Bdabrowsky/T800-SRM/README.md

# T800-SRM
T800 is a solid rocket motor developed for Odkrywcy Diamentow grant program in years 2021-2024. This repository is a technical report of this project
