Bdabrowsky/T800-SRM/Design files/T800.step

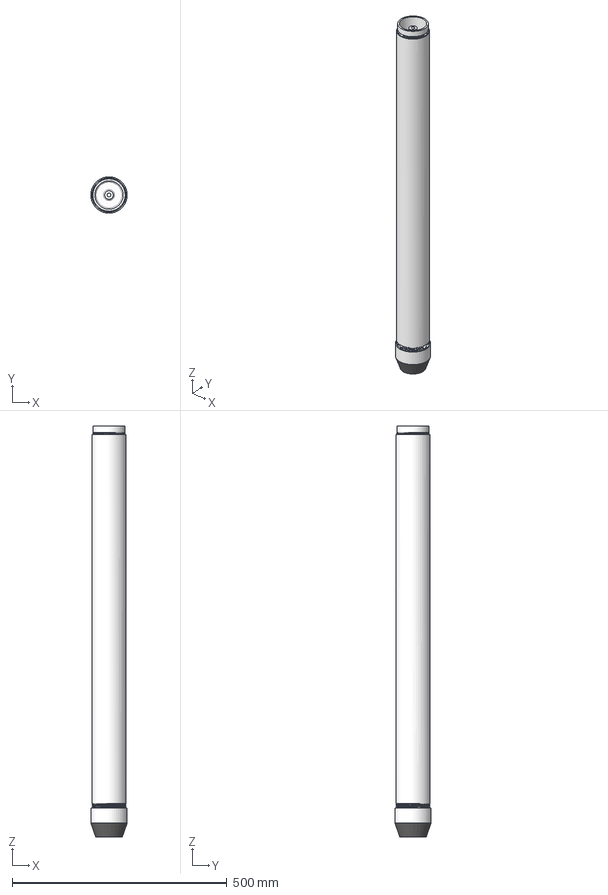
[picture p8: CAD file, 2024-02-15]
Design files/T800.step
84.9 x 85.0 x 957.7 mm
Casing
Graphite
Liner
Casting tube x 6
Fuel grain x 6
Top closure
Liner cap
