Bdabrowsky/T800-SRM/Images/Assembly cross section.png

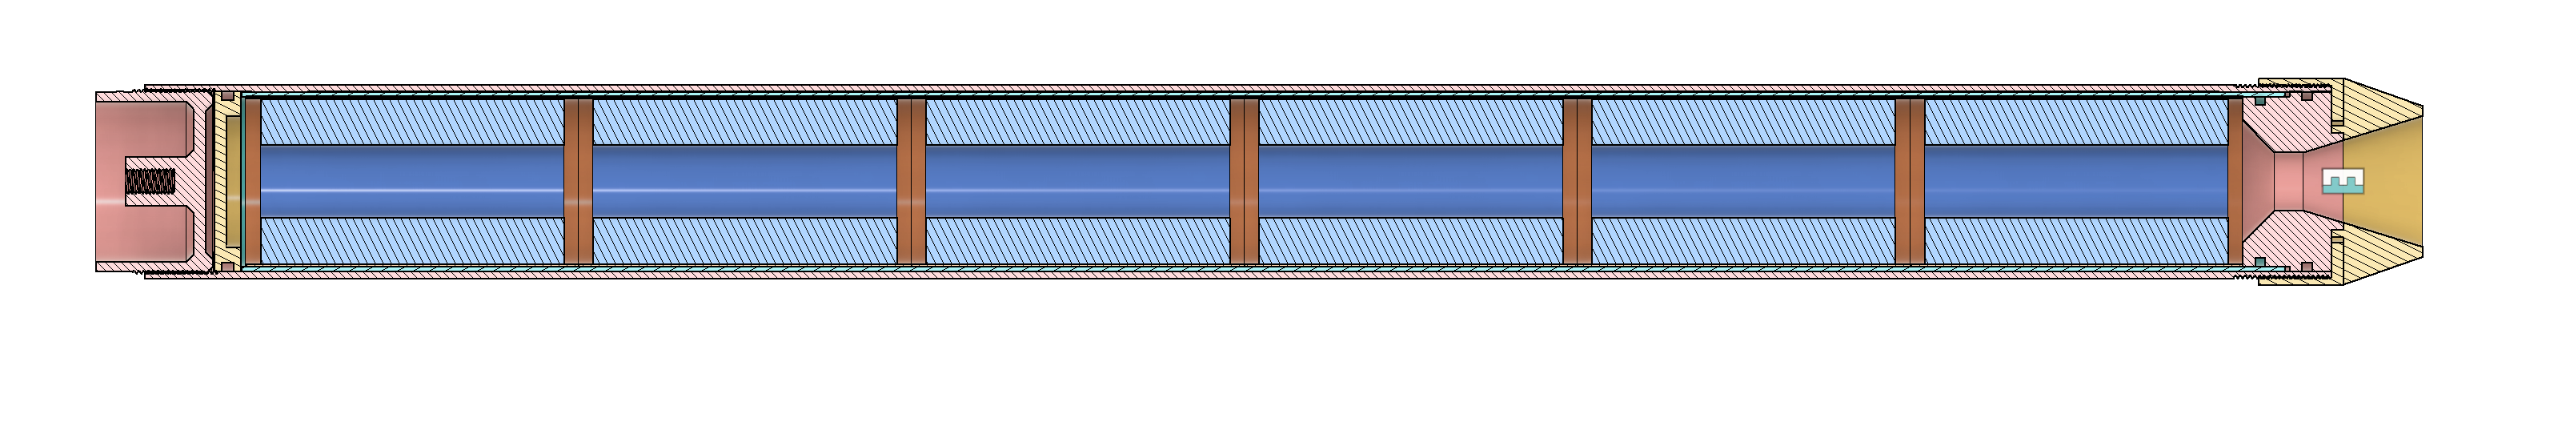
Images/Assembly cross section.png
