Bdabrowsky/T800-SRM/Images/Assembly.png

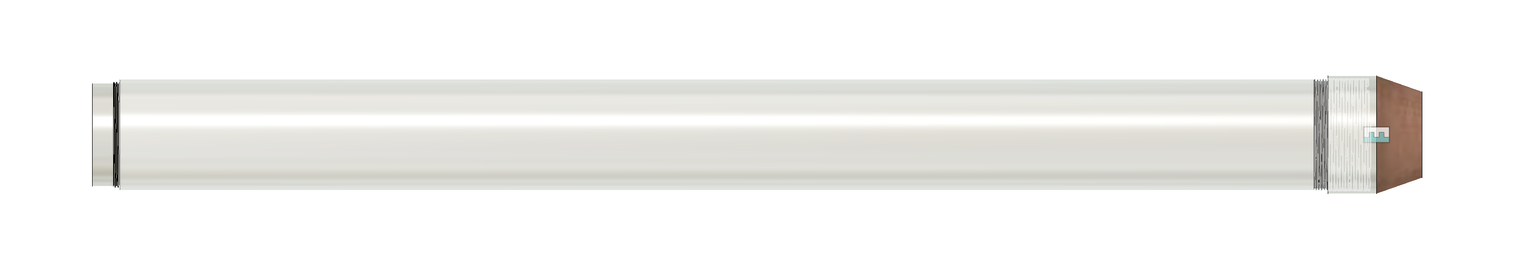
Images/Assembly.png
