Bdabrowsky/T800-SRM/Design files/T800 Drawing.pdf

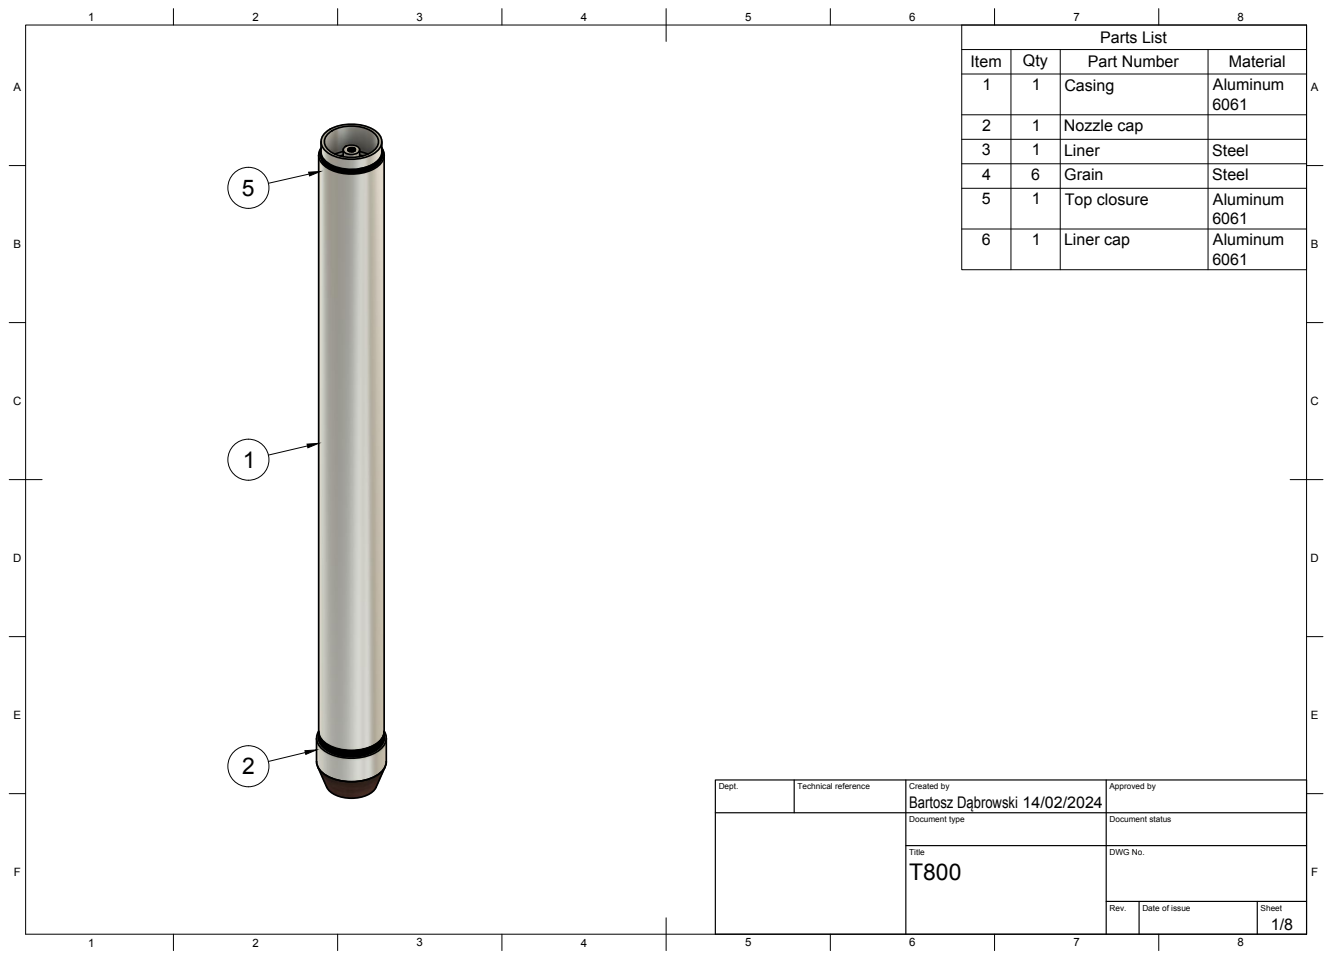
[picture p11: page 1]
Title; DWG No.; Rev.; Date of issue; Sheet; Parts List

Item | Qty | Part Number | Material
1 | 1 | Casing | Aluminum 6061

2 | 1 | Nozzle cap
3 | 1 | Liner | Steel
4 | 6 | Grain | Steel
5 | 1 | Top closure | Aluminum 6061

6 | 1 | Liner cap | Aluminum 6061

Dept. | Technical reference | Created by Bartosz Dąbrowski 14/02/2024 | Approved by

Document type | Document status

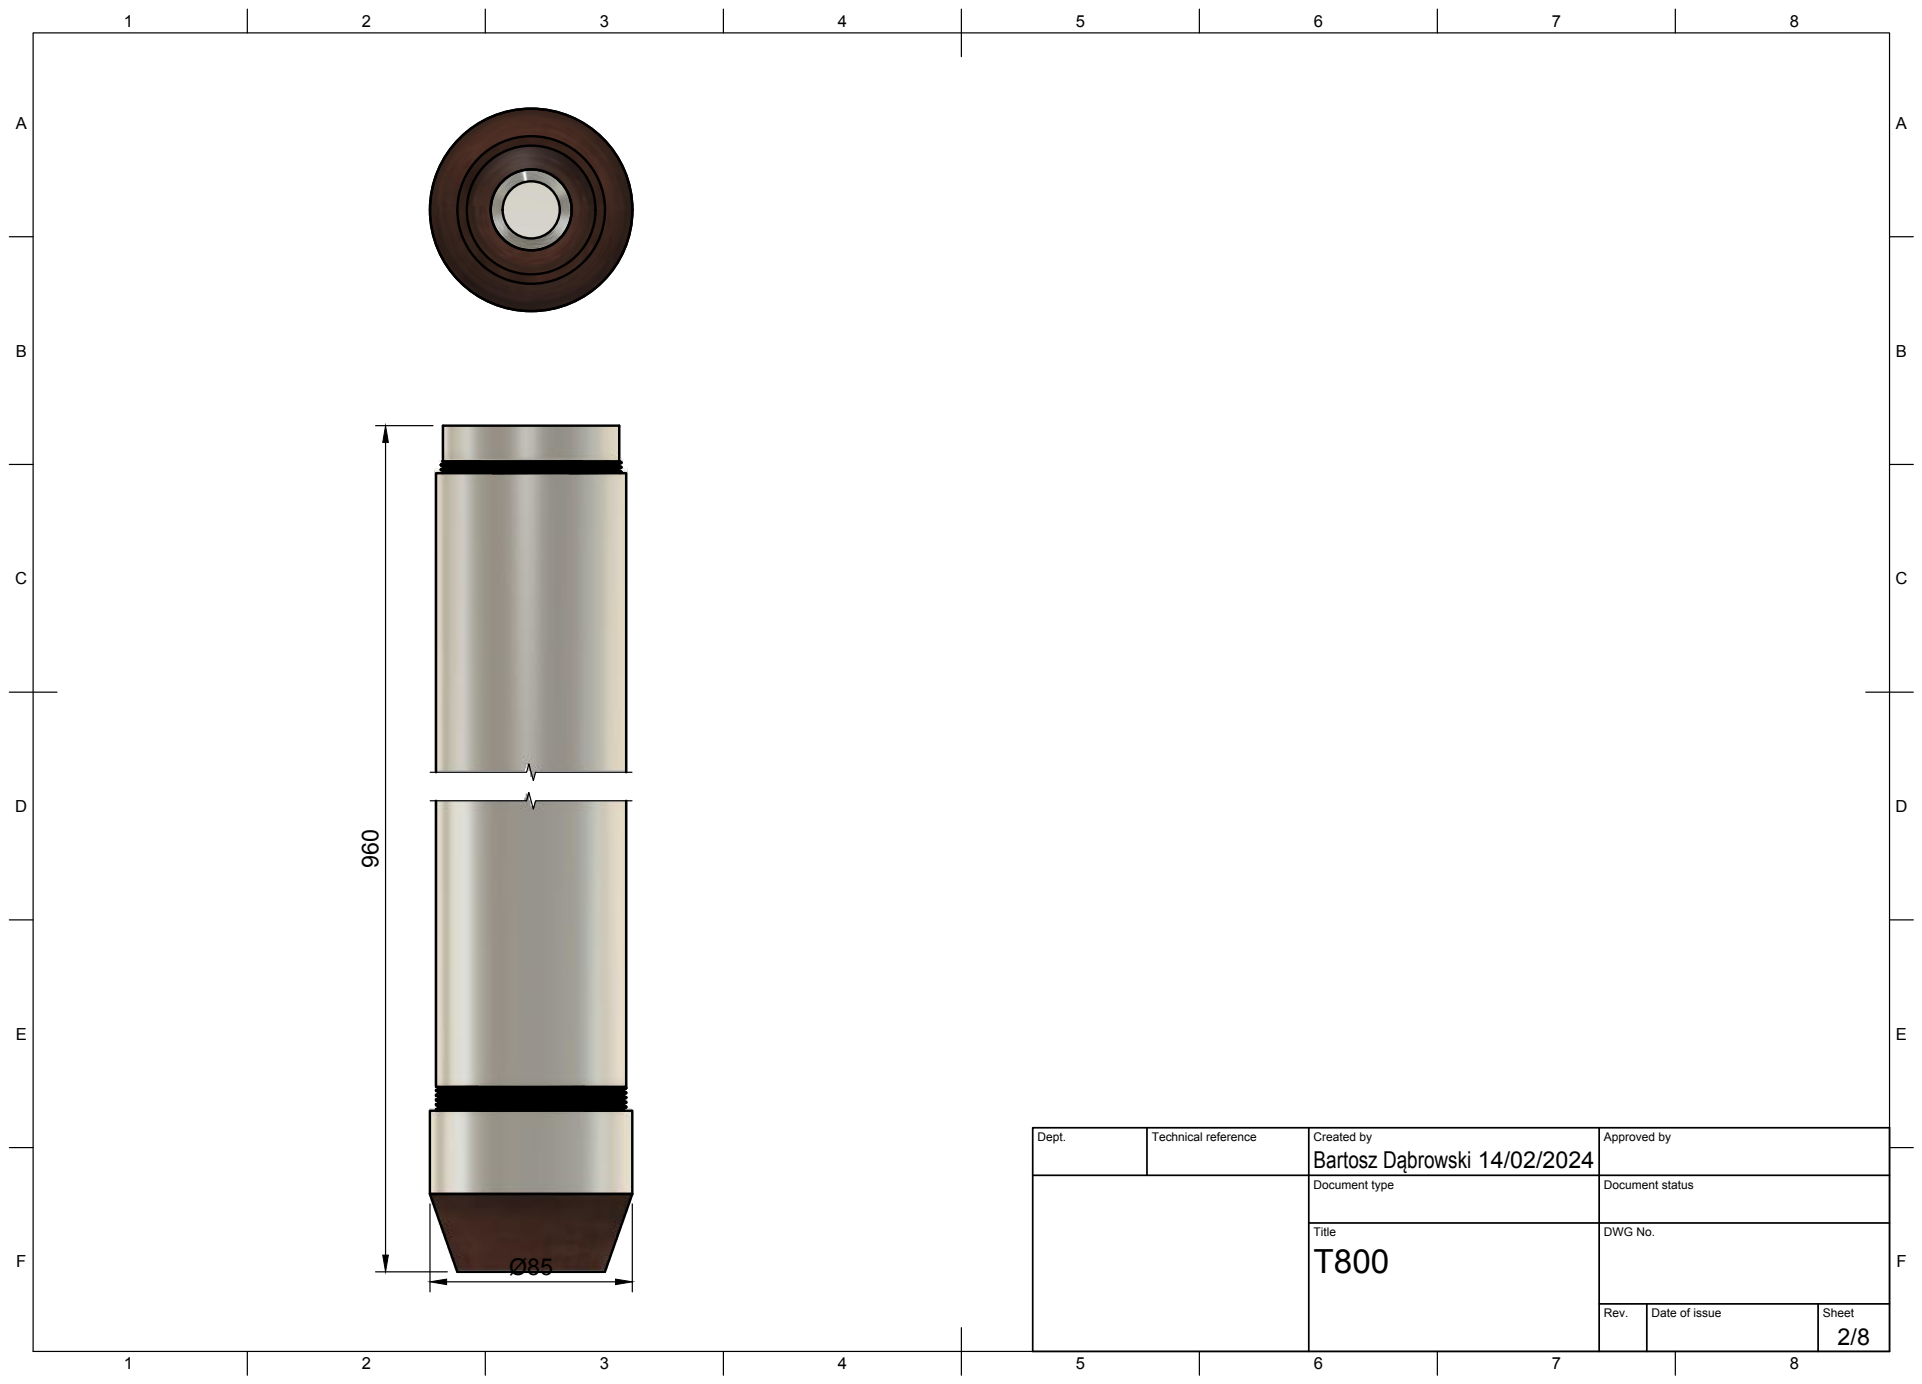
[picture p12: page 2]
Title; DWG No.

Dept. | Technical reference | Created by Bartosz Dąbrowski 14/02/2024 | Approved by

Document type | Document status

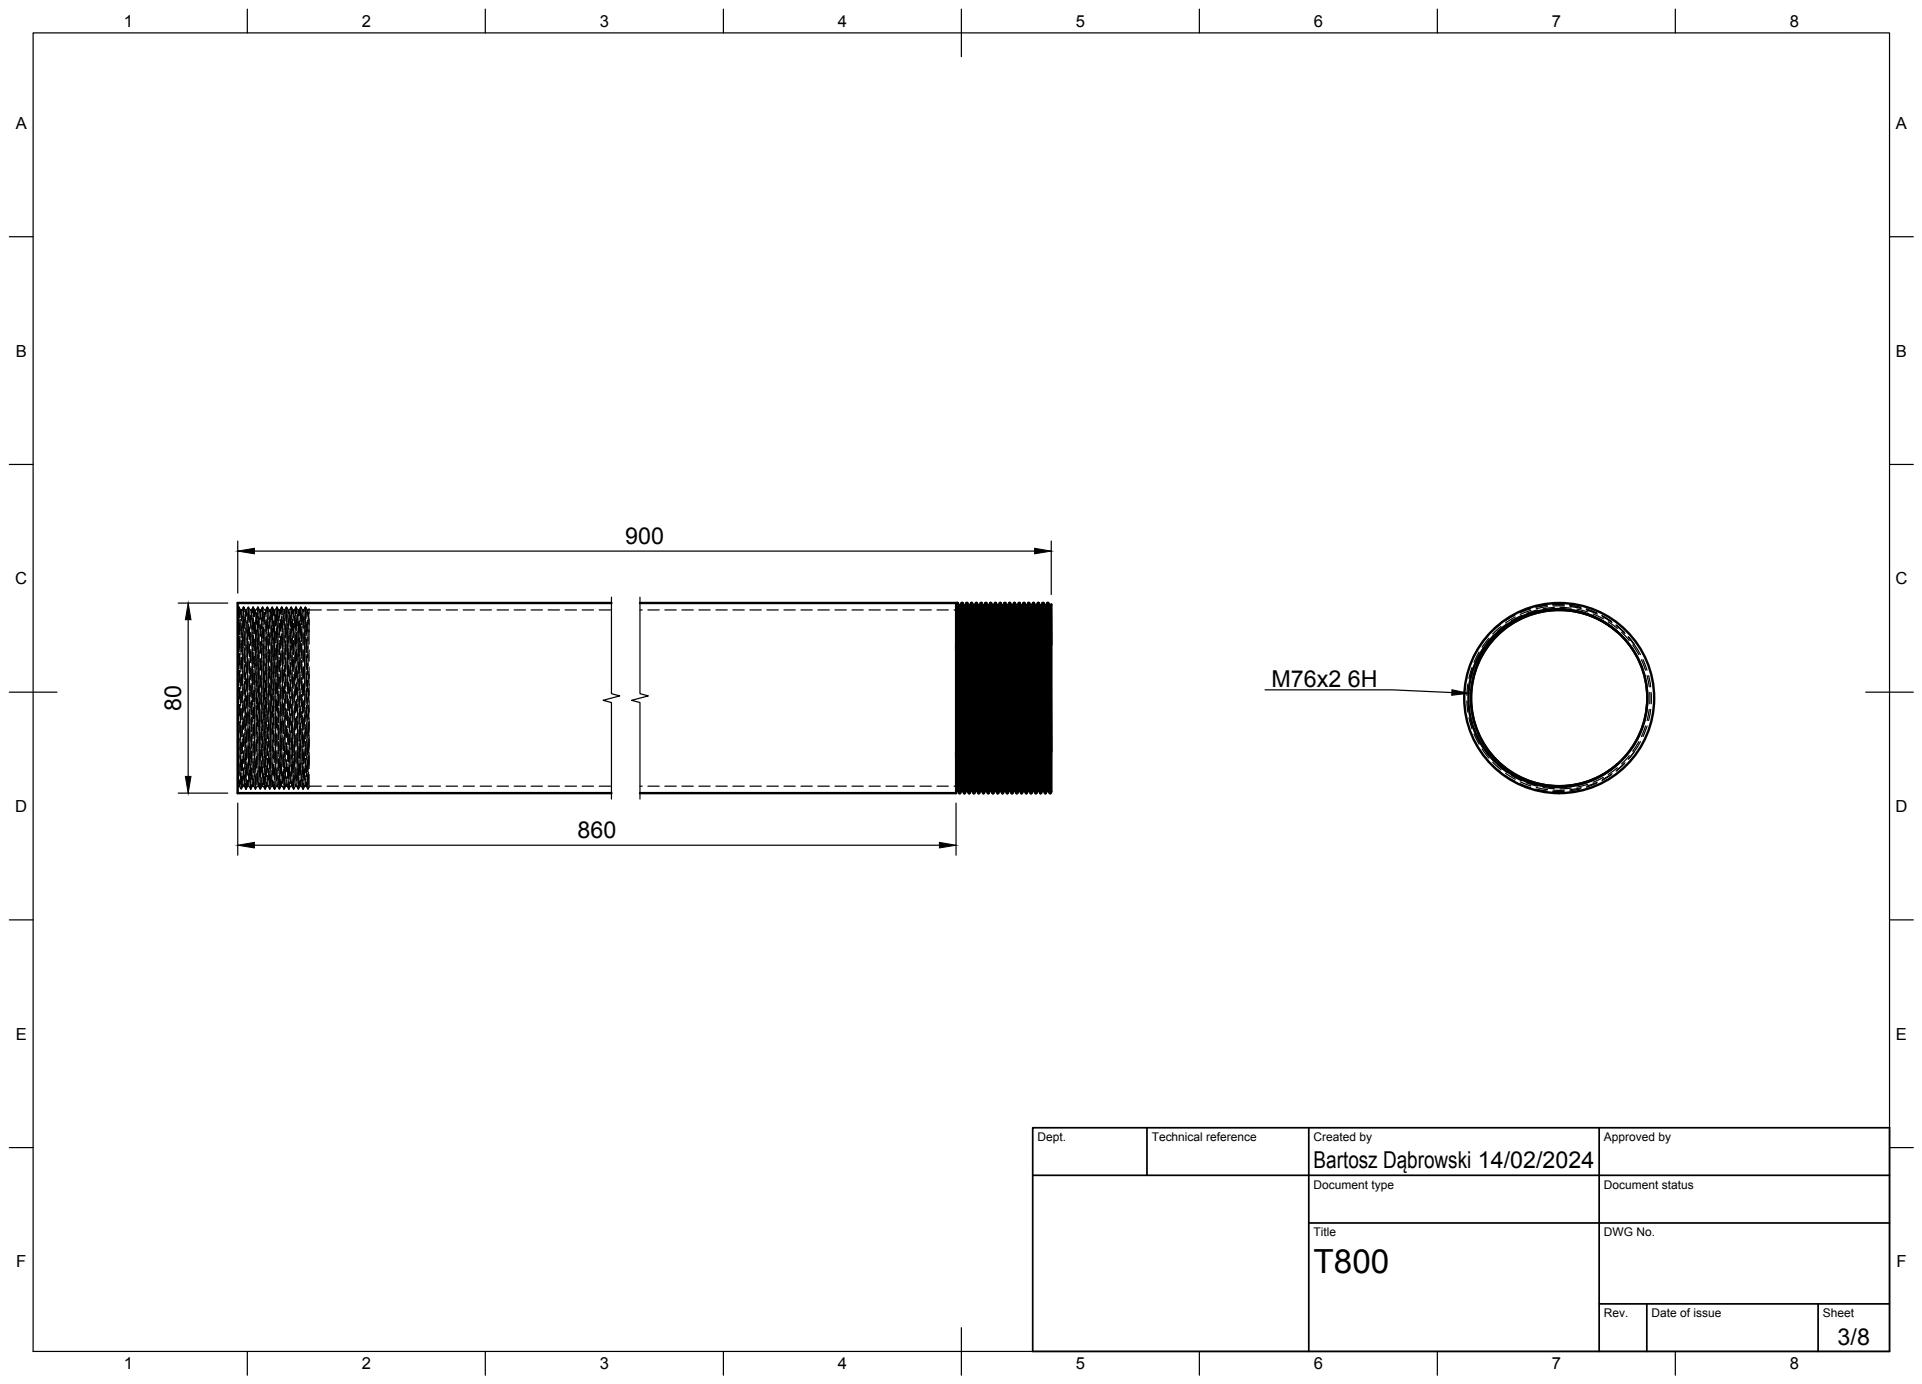
[picture p13: page 3]
Title; DWG No.; Bartosz Dąbrowski 80

Dept. | Technical reference | Created by 14/02/2024 | Approved by

Document type | Document status

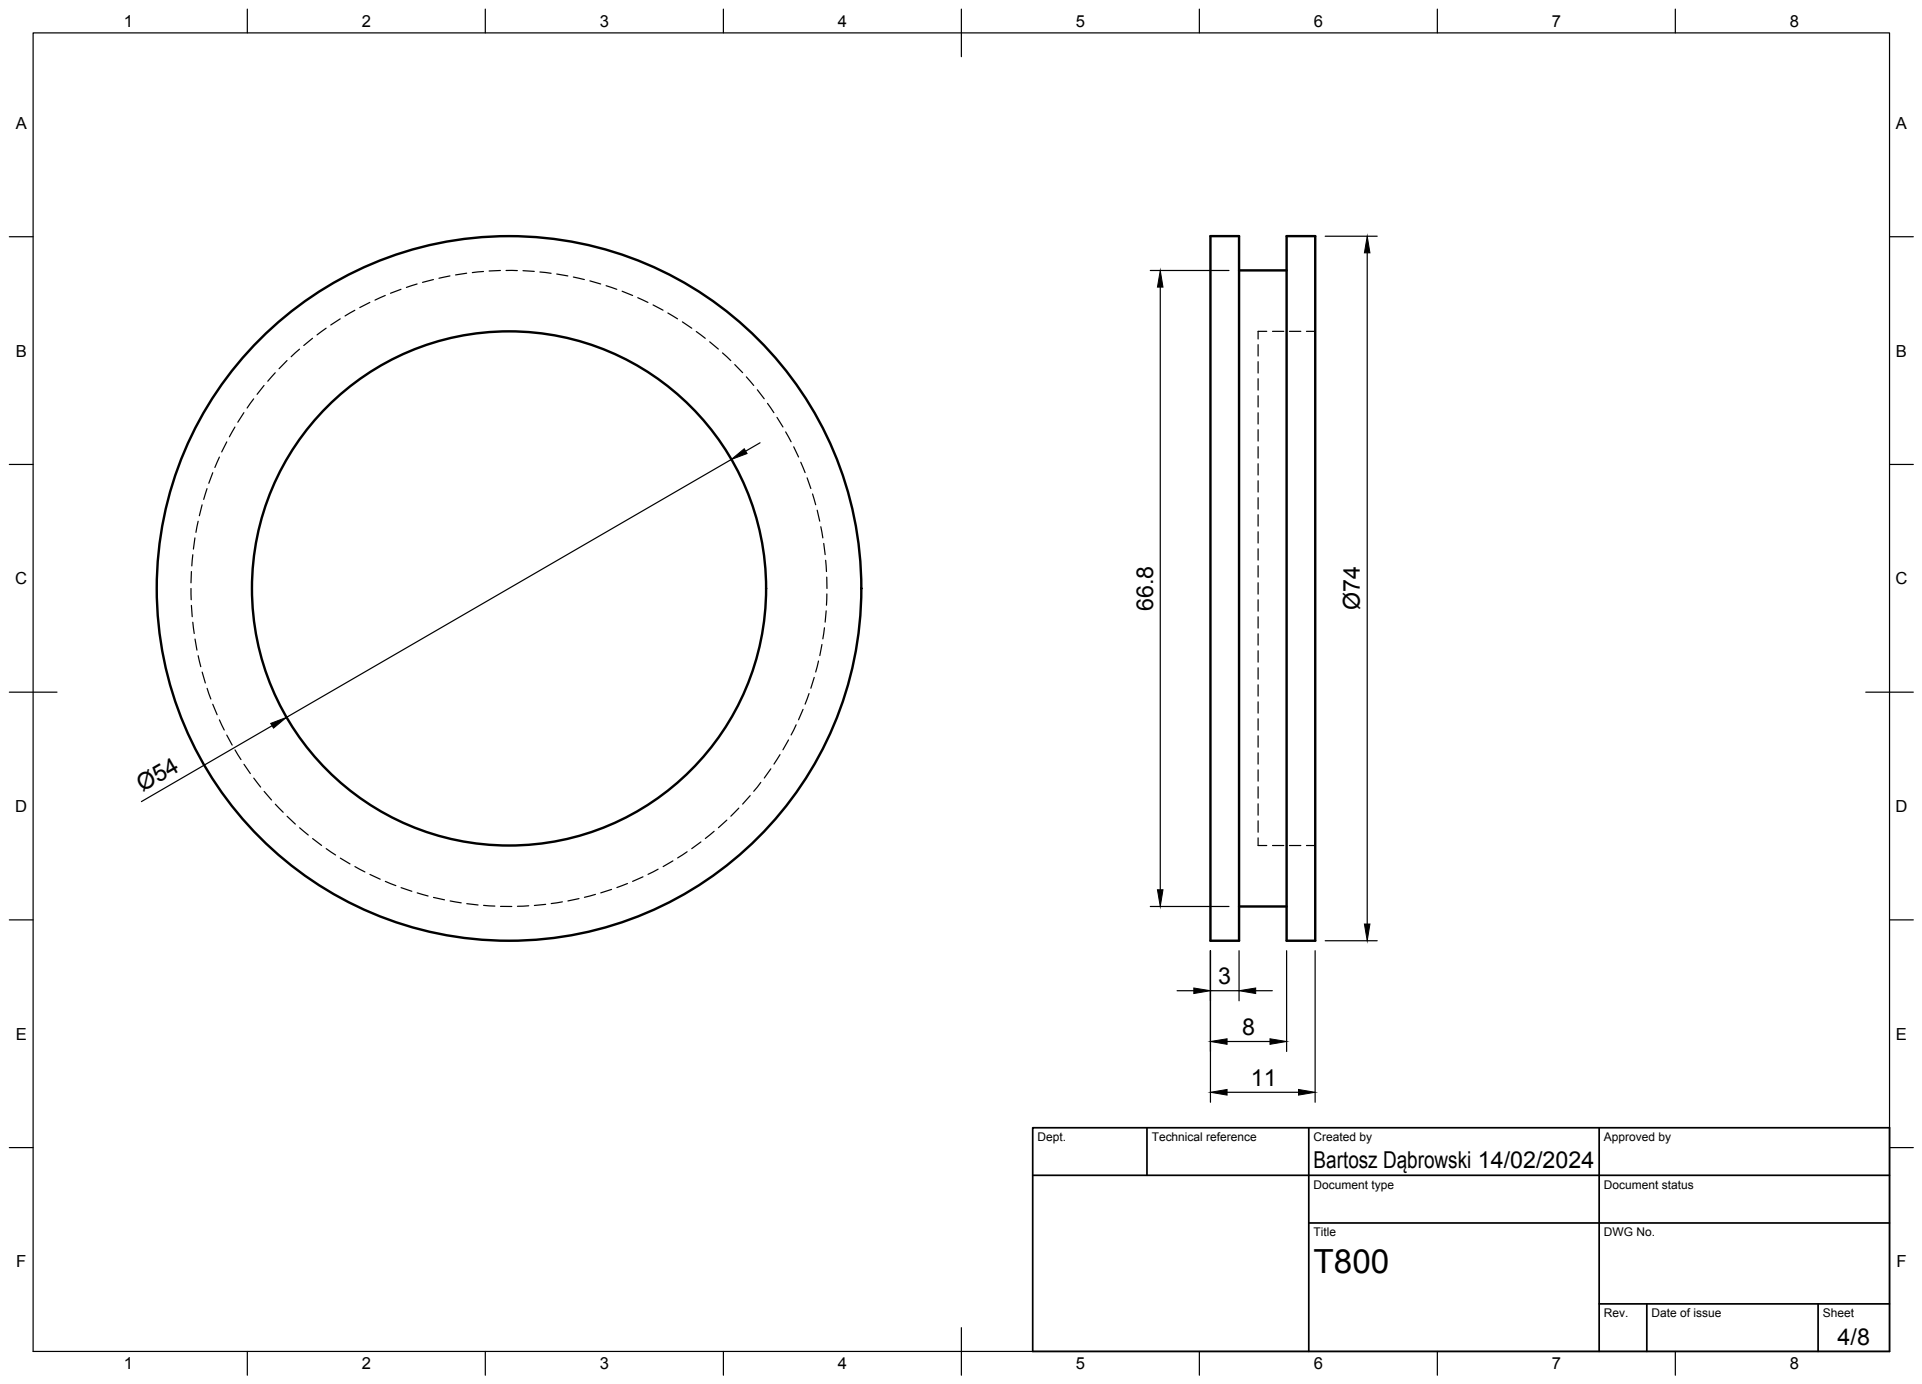
[picture p14: page 4]
Title; DWG No.; Bartosz Dąbrowski Ø74

Dept. | Technical reference | Created by 14/02/2024 | Approved by

Document type | Document status

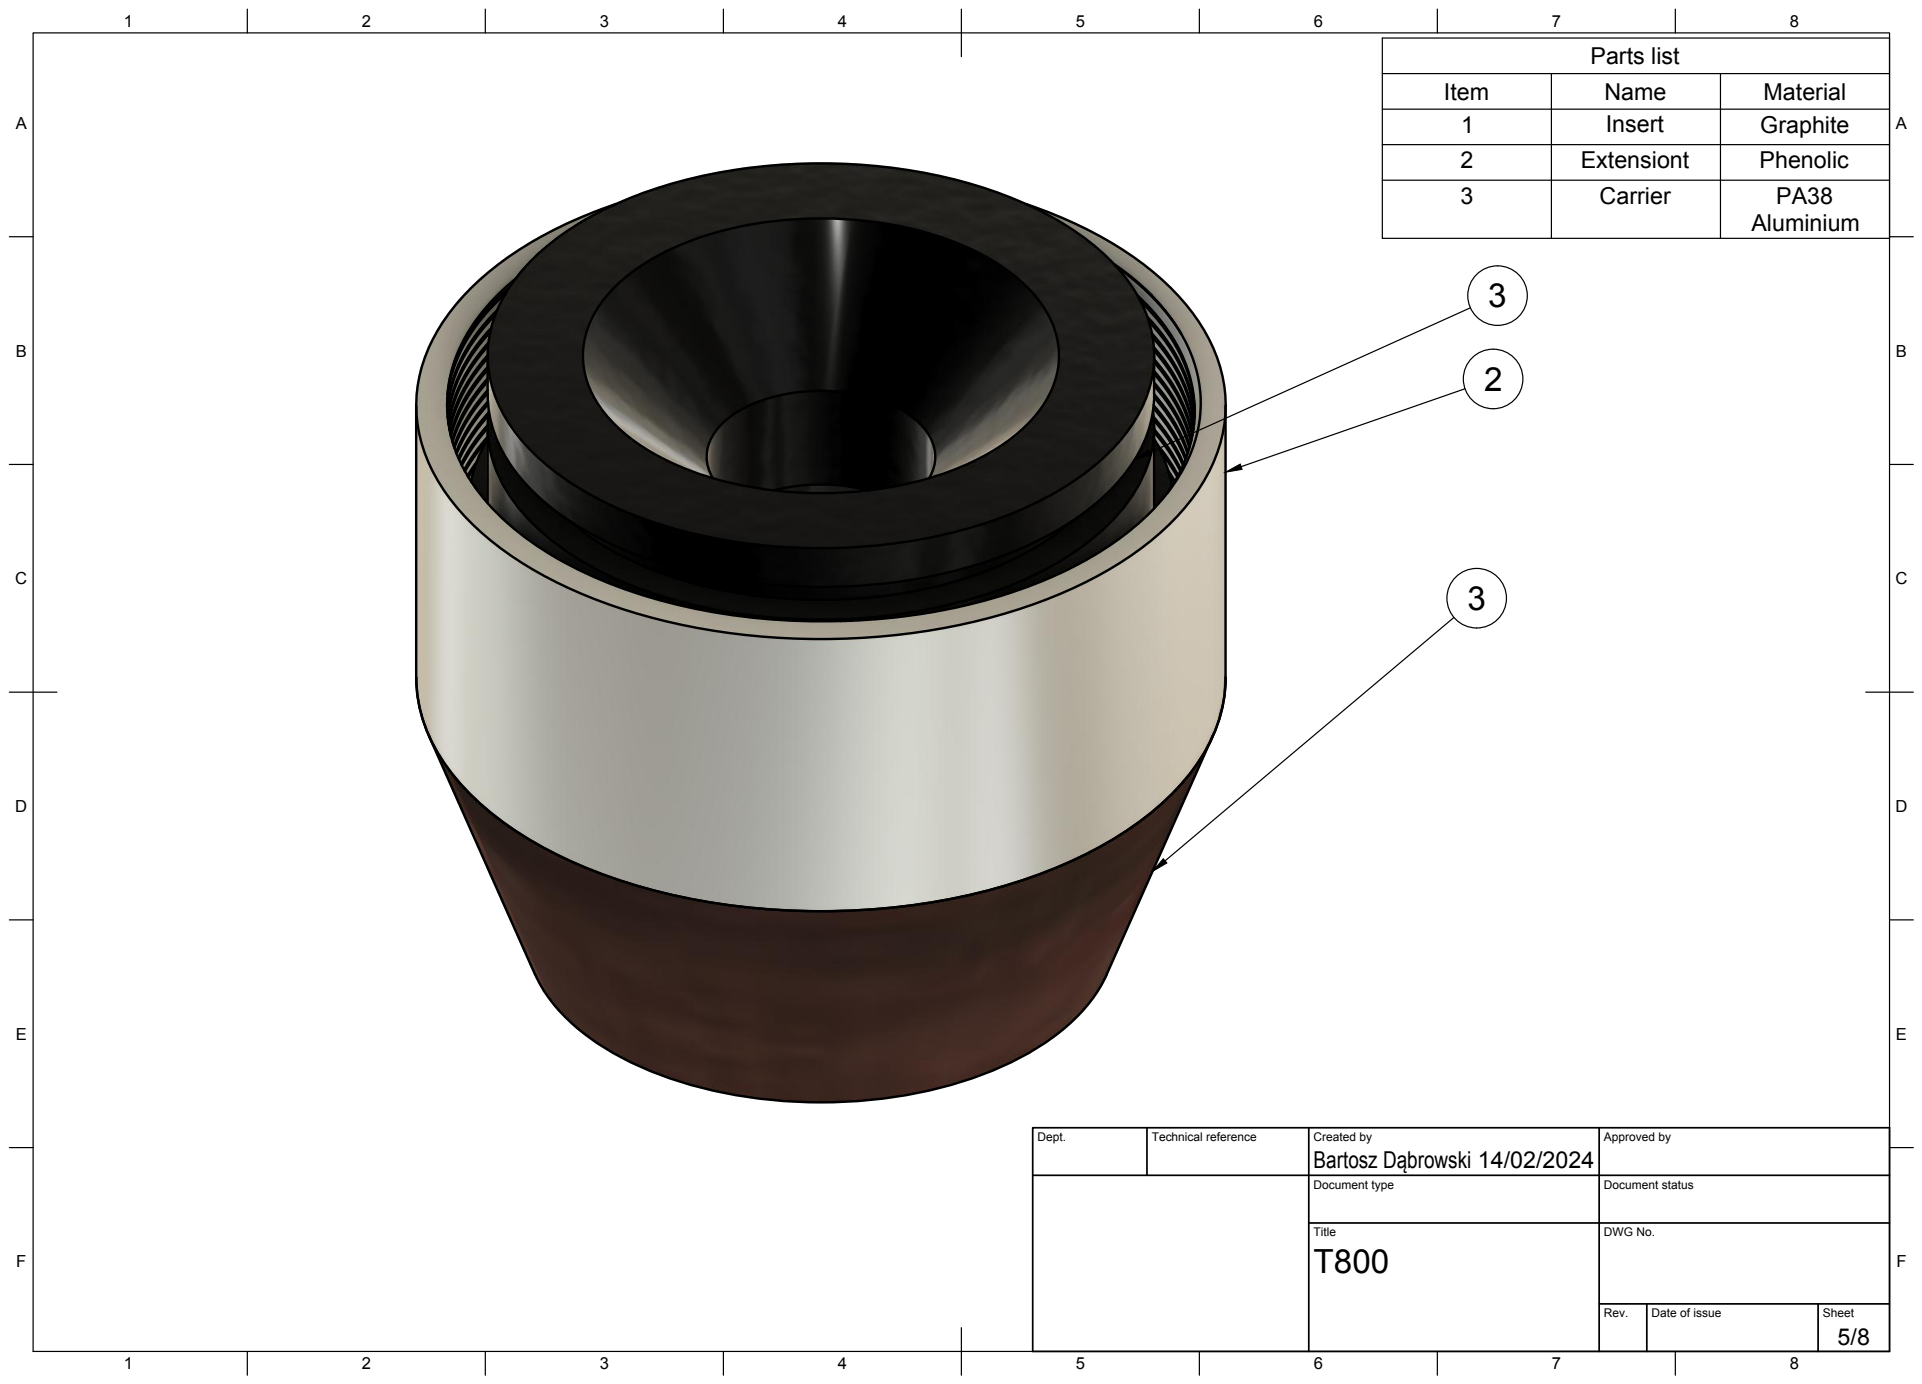
[picture p15: page 5]
Title; DWG No.; Parts list

Item | Name | Material
1 | Insert | Graphite
2 | Extensiont | Phenolic
3 | Carrier | PA38 Aluminium

Dept. | Technical reference | Created by Bartosz Dąbrowski 14/02/2024 | Approved by

Document type | Document status

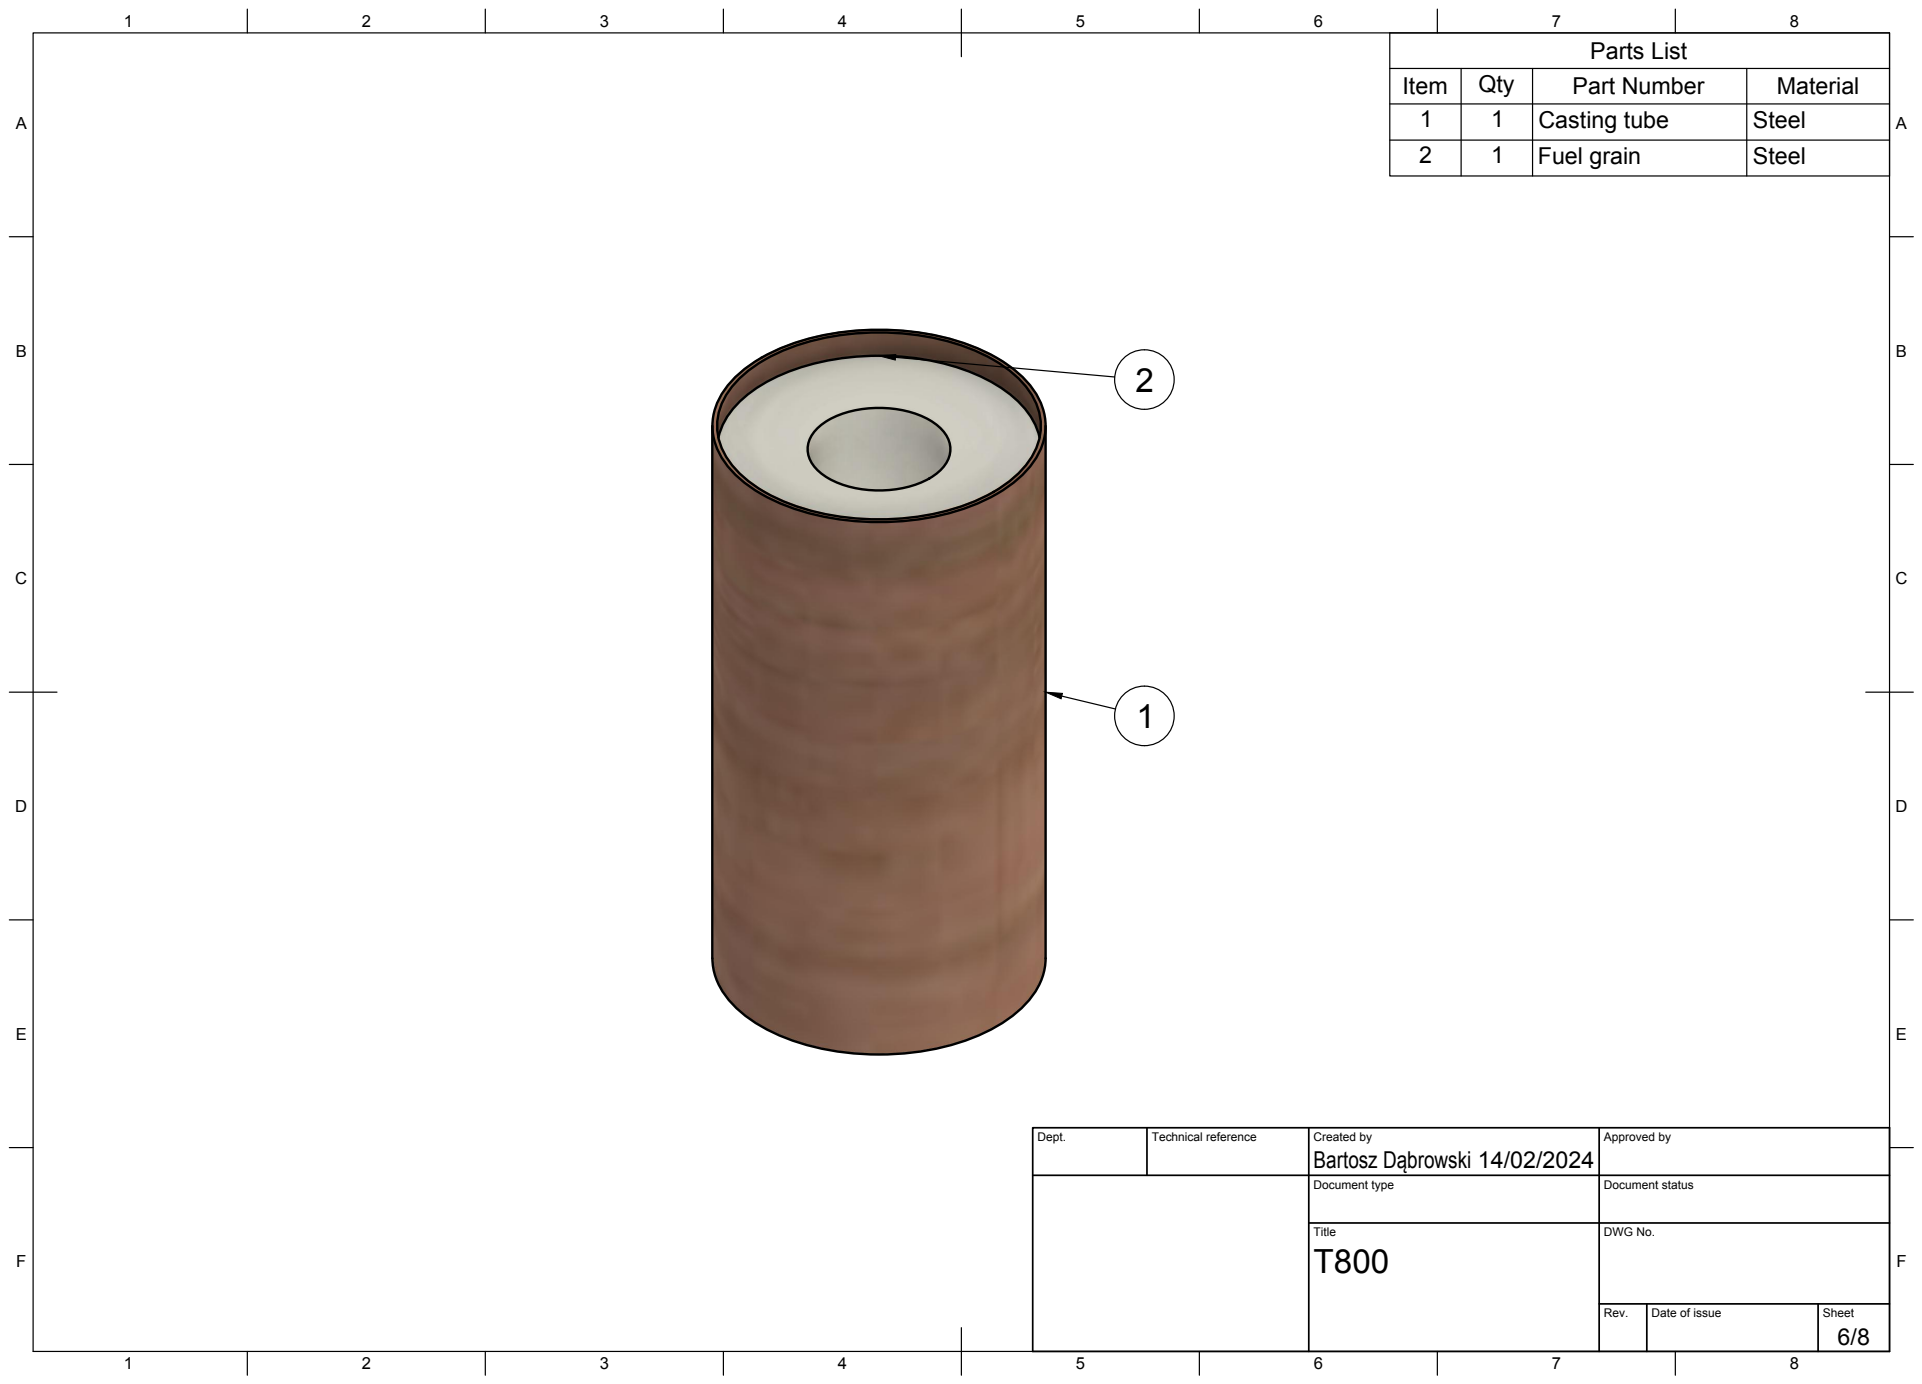
[picture p16: page 6]
Title; DWG No.; Parts List

Item | Qty | Part Number | Material
1 | 1 | Casting tube | Steel
2 | 1 | Fuel grain | Steel

Dept. | Technical reference | Created by Bartosz Dąbrowski 14/02/2024 | Approved by

Document type | Document status

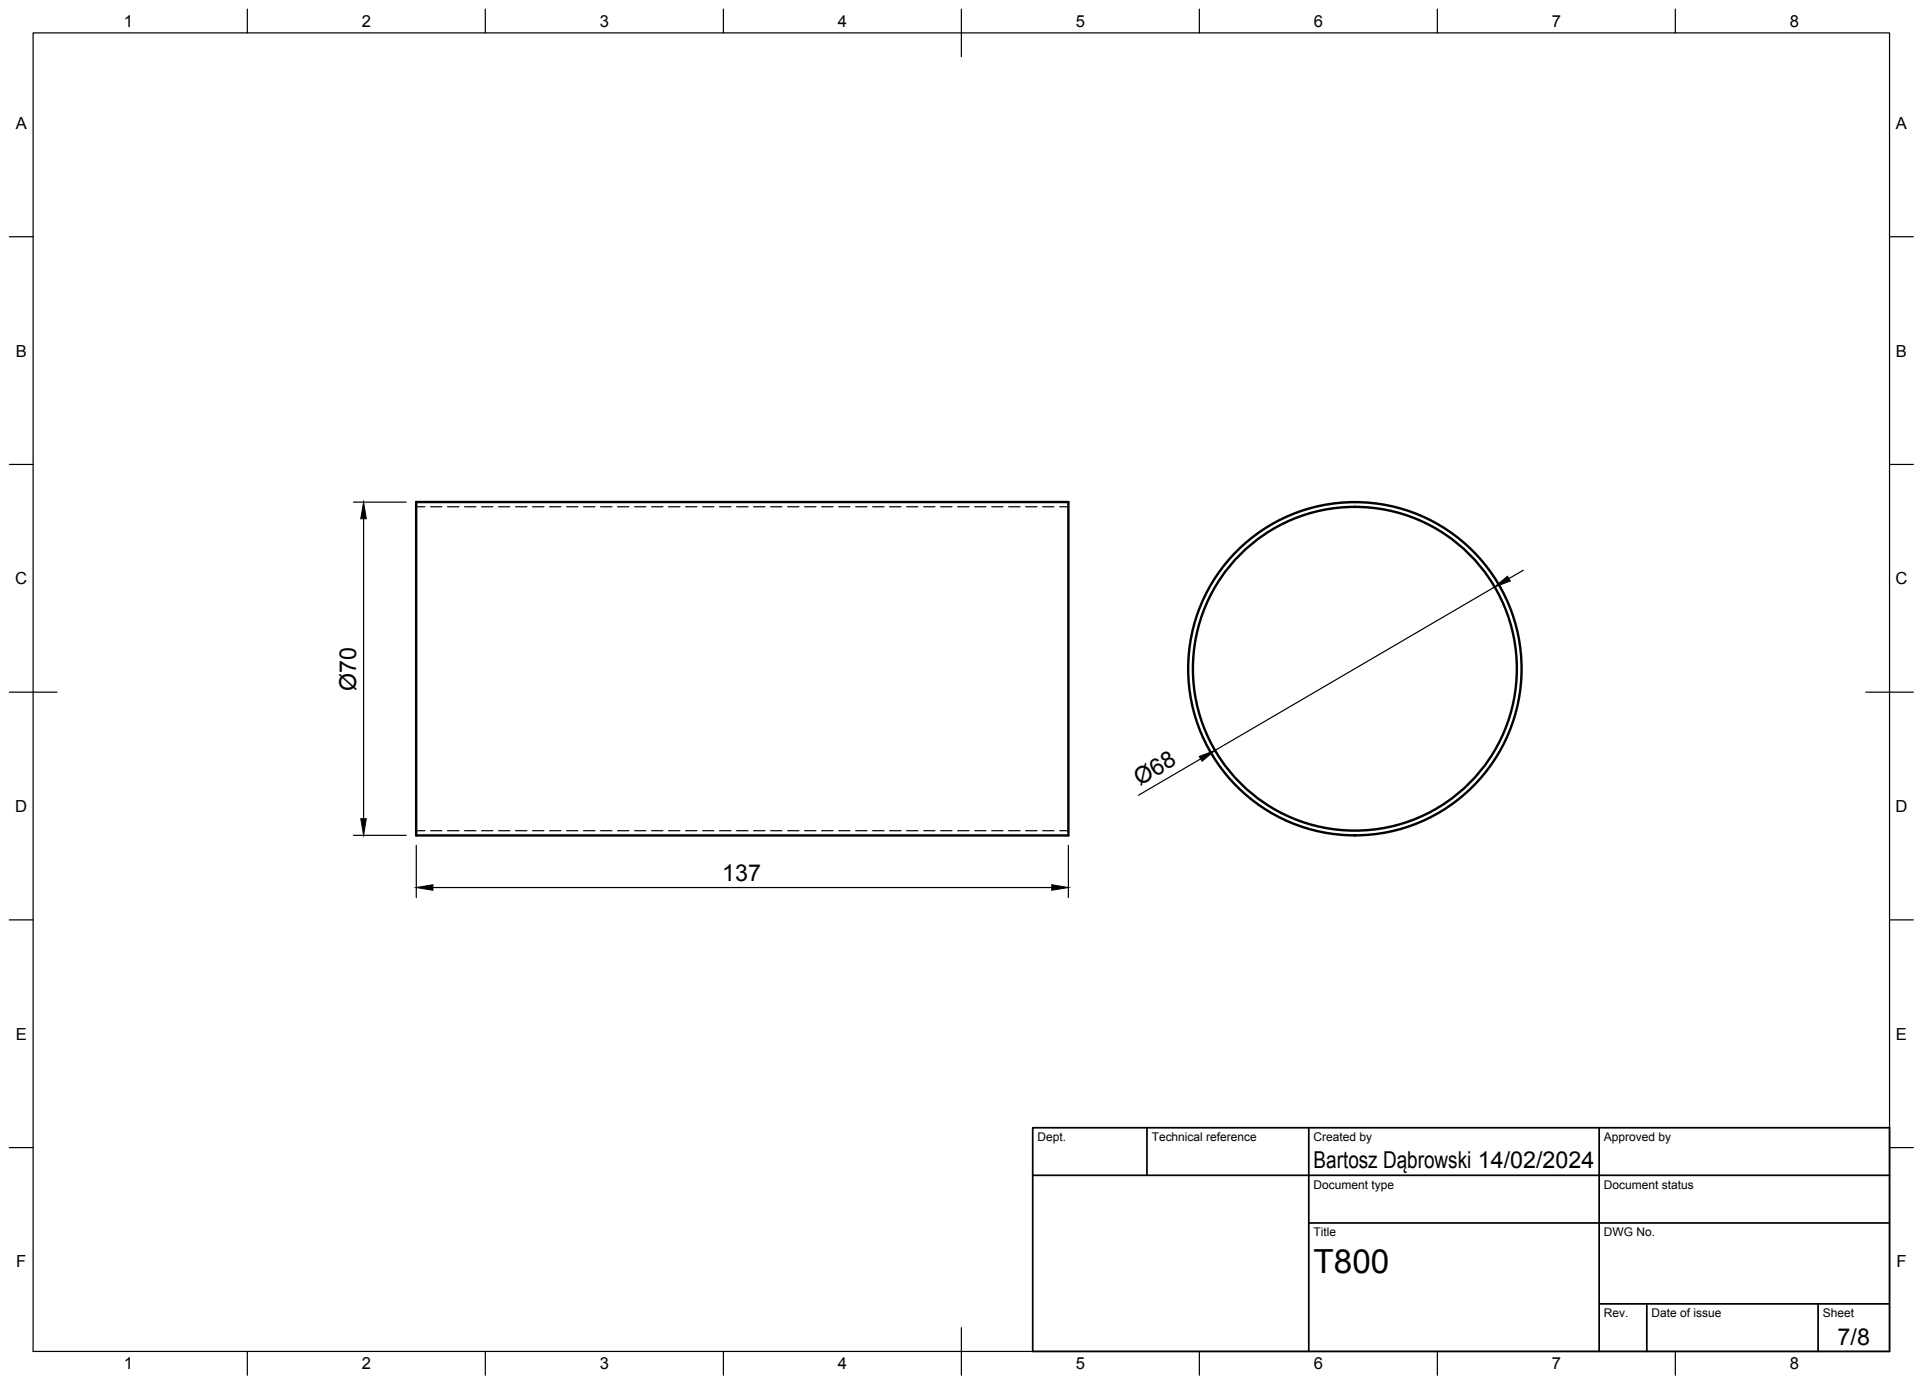
[picture p17: page 7]
Title; DWG No.

Dept. | Technical reference | Created by Bartosz Dąbrowski 14/02/2024 | Approved by

Document type | Document status

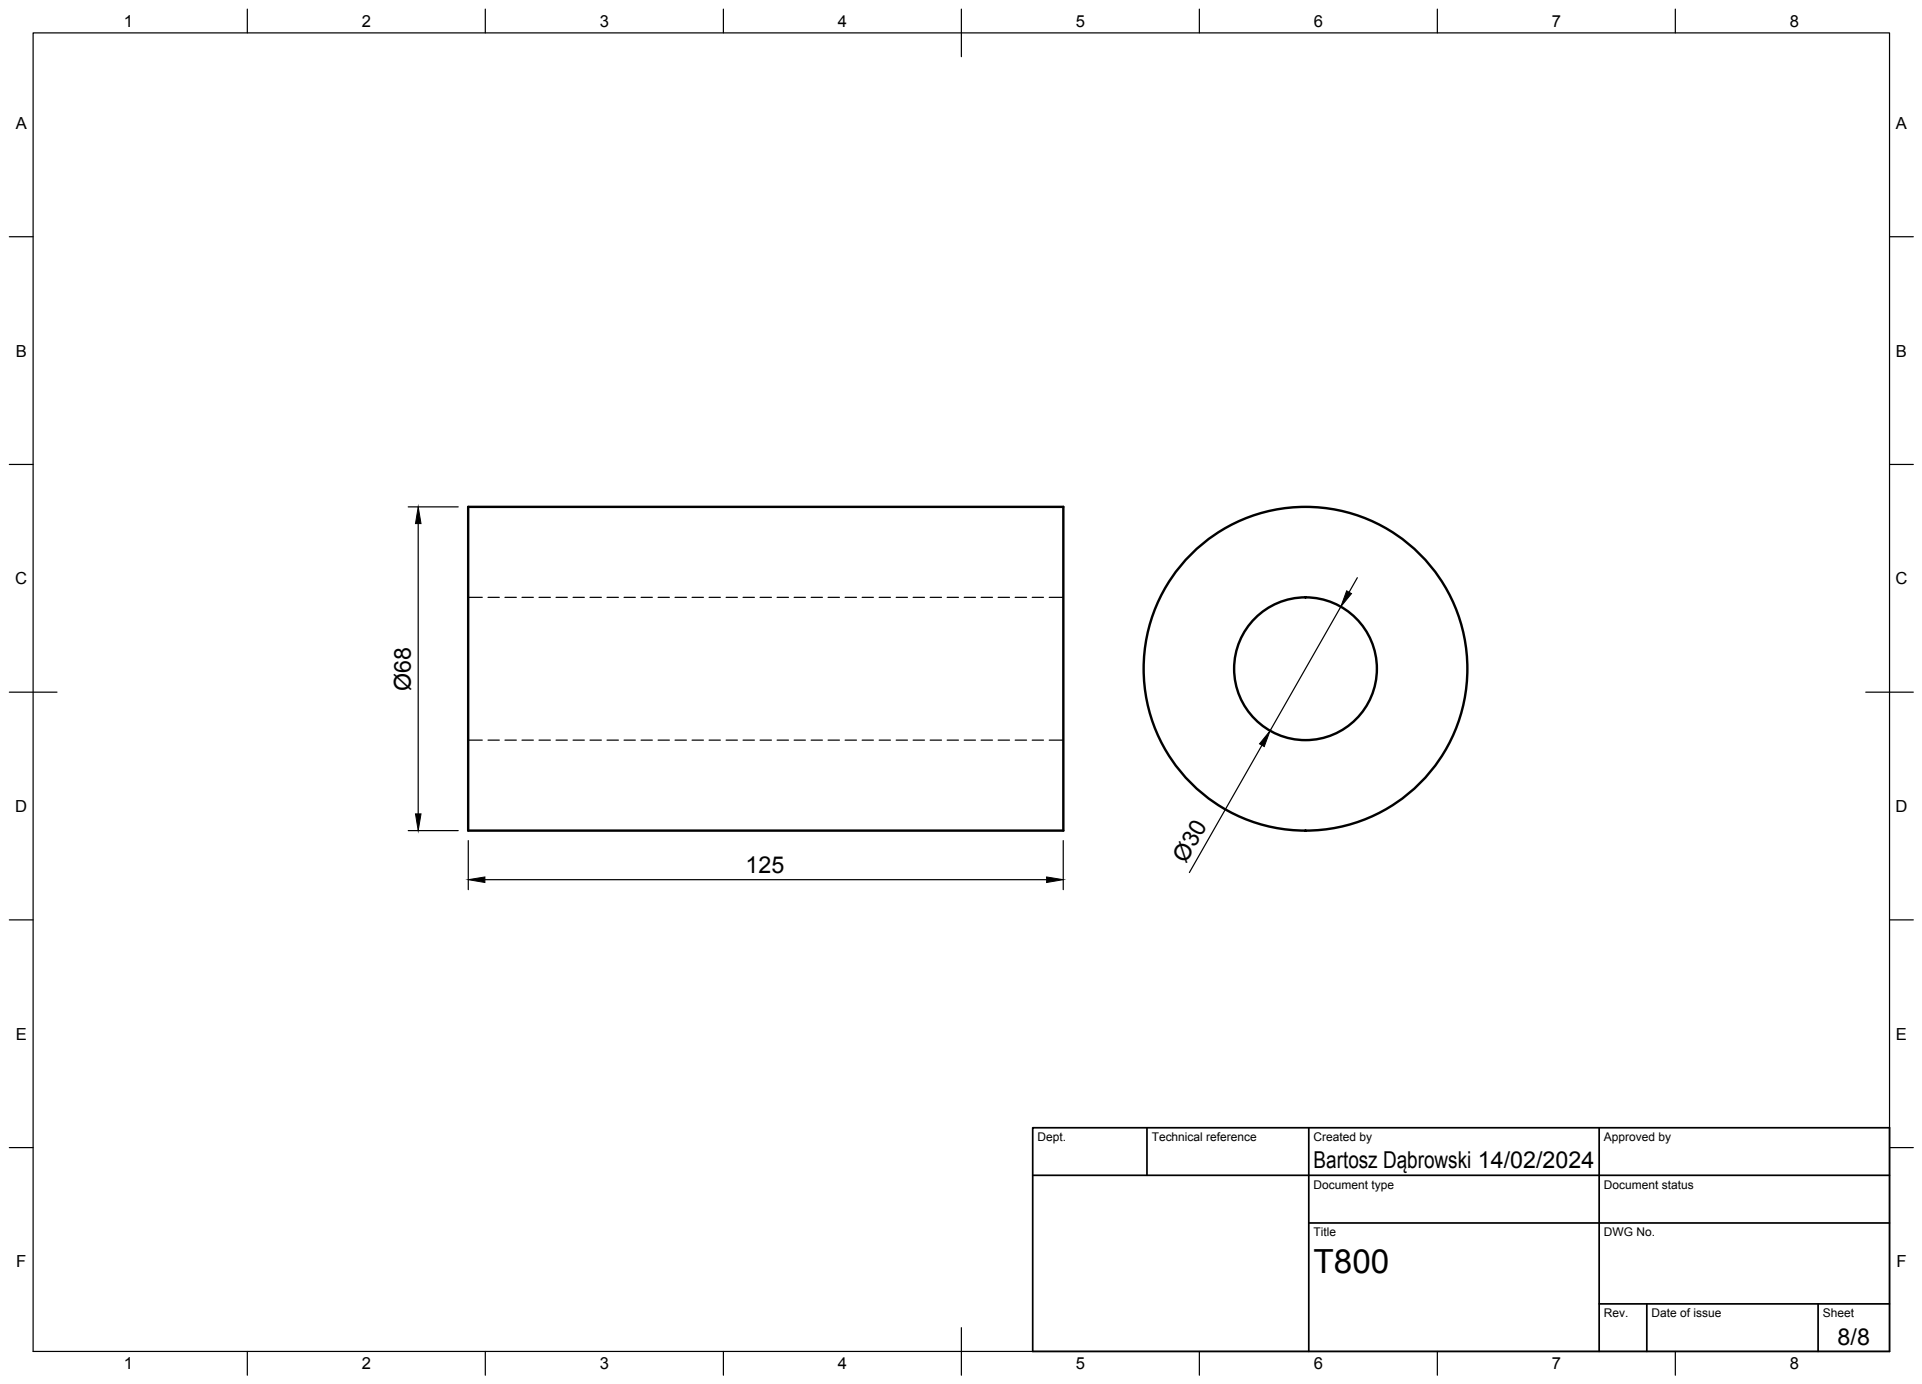
[picture p18: page 8]
Title; DWG No.

Dept. | Technical reference | Created by Bartosz Dąbrowski 14/02/2024 | Approved by

Document type | Document status
