Bdabrowsky/T800-SRM/(commit log)

2024-02-15 Added motor CAD
    [T800.step]
2024-02-15 Final commit
    [T800.step]
